mole99/tt08-aicd-playground/docs/tt_um_tt08_aicd_playground_schematic.md

# CACE Summary for tt_um_tt08_aicd_playground

**netlist source**: schematic

| Parameter | Tool | Result | Min Limit  |  Min Value | Typ Target |  Typ Value | Max Limit  |  Max Value |  Status  |
| :--- | :--- | :--- | ---: | ---: | ---: | ---: | ---: | ---: | :---: |
| Area | magic_area | area | | | | | any | | Skip 🟧 |
| Width | magic_area | width | | | | | any | | Skip 🟧 |
| Height | magic_area | height | | | | | any | | Skip 🟧 |
| Magic DRC | magic_drc | drc_errors | | | | | 0 | | Skip 🟧 |
| Netgen LVS | netgen_lvs | lvs_errors | | | | | 0 | | Skip 🟧 |
| KLayout DRC feol | klayout_drc | drc_errors | | | | | 0 | | Skip 🟧 |
| KLayout DRC beol | klayout_drc | drc_errors | | | | | 0 | | Skip 🟧 |
| KLayout DRC full | klayout_drc | drc_errors | | | | | 0 | | Skip 🟧 |

## Plots
