mole99/tt08-aicd-playground/docs/tt_um_tt08_aicd_playground_layout.md

# CACE Summary for tt_um_tt08_aicd_playground

**netlist source**: layout

| Parameter | Tool | Result | Min Limit  |  Min Value | Typ Target |  Typ Value | Max Limit  |  Max Value |  Status  |
| :--- | :--- | :--- | ---: | ---: | ---: | ---: | ---: | ---: | :---: |
| Area | magic_area | area | | | | | any | 71554.422 µm² | Pass ✅ |
| Width | magic_area | width | | | | | any | 316.095 µm | Pass ✅ |
| Height | magic_area | height | | | | | any | 226.370 µm | Pass ✅ |
| Magic DRC | magic_drc | drc_errors | | | | | 0 | 0 | Pass ✅ |
| Netgen LVS | netgen_lvs | lvs_errors | | | | | 0 | 0 | Pass ✅ |
| KLayout DRC feol | klayout_drc | drc_errors | | | | | 0 | 0 | Pass ✅ |
| KLayout DRC beol | klayout_drc | drc_errors | | | | | 0 | 0 | Pass ✅ |
| KLayout DRC full | klayout_drc | drc_errors | | | | | 0 | 0 | Pass ✅ |

## Plots
