mole99/tt08-aicd-playground/(commit log)

2024-08-12 Add design
    [transient_tb.sch, tt08-aicd-playground.sch]
2024-08-12 Flatten levelshifter_up
    [transient_tb.sch, tt08-aicd-playground.sch]
2024-08-19 Update design and CACE setup
    [pad_model.sch, transient_tb.sch, tt08-aicd-playground.sch, tt_um_tt08_aicd_playground.sch]
2024-08-20 Top level integration
    [tt_um_tt08_aicd_playground.sch]
2024-08-21 Update design
    [tt_um_tt08_aicd_playground.sch]
2024-08-21 Update pin info
2024-08-27 Clean up schematic
    [tt_um_tt08_aicd_playground.sch]
